BrownSpaceEngineering/PVDX-ADCS-PMB/PVDX-ADCS-PMB.step

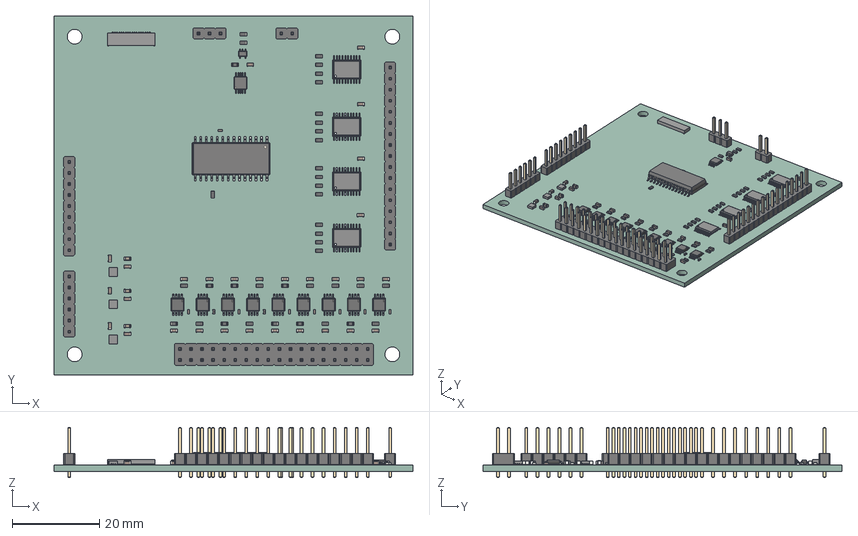
[picture p1: CAD file, 2026-08-29]
PVDX-ADCS-PMB.step
82.5 x 82.5 x 11.5 mm
C_0402_1005Metric x 10
R_0603_1608Metric x 38
BODY_MUA08A x 9
LEAD_MUA08A x 72
SOIC-28W_7.5x17.9mm_P1.27mm
C_0603_1608Metric x 29
BODY-SON x 3
PIN1-ID x 3
PinHeader_1x03_P2.54mm_Vertical
Pins
SOT-353_SC-70-5
SOP65P640X120-20N x 4
GRM188R61A226ME15D x 3
PinHeader_2x18_P2.54mm_Vertical
PinHeader_1x02_P2.54mm_Vertical
TSSOP-10_3x3mm_P0.5mm
PinHeader_1x09_P2.54mm_Vertical
PinHeader_1x17_P2.54mm_Vertical
PinHeader_1x06_P2.54mm_Vertical
PVDX-ADCS-PMB_PCB
