BrownSpaceEngineering/PVDX-ADCS-PMB/manufacturing/rev-1.1_2026-09-04/plots/PVDX-ADCS-PMB.pdf

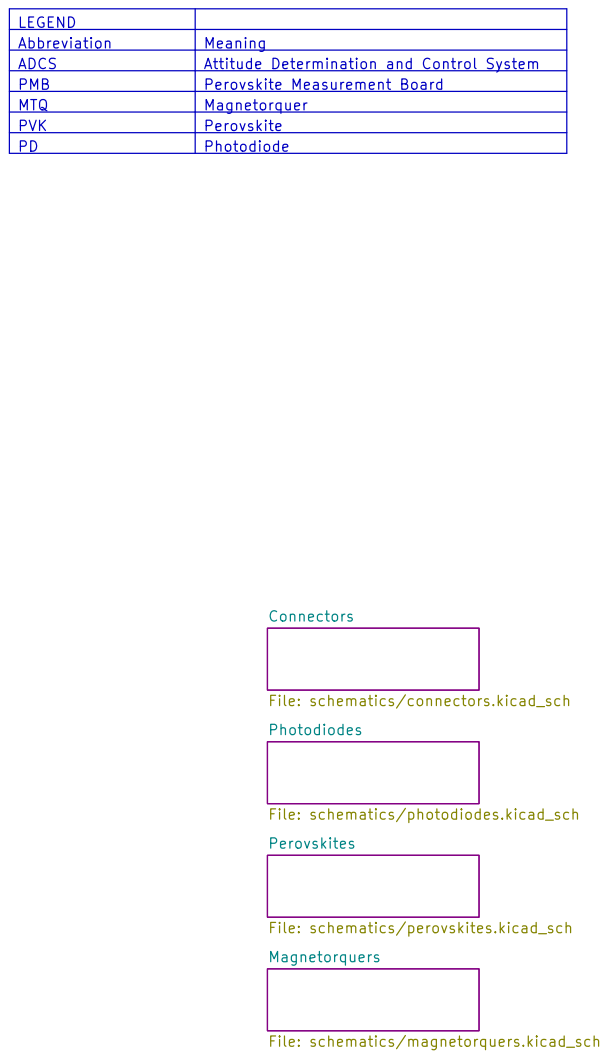
[picture p2: page 1]

LEGEND
Abbreviation | Meaning
ADCS | Attitude Determination and Control System

Magnetorquers File: schematics/magnetorquers.kicad_sch Connectors File: schematics/connectors.kicad_sch Photodiodes File: schematics/photodiodes.kicad_sch Perovskites File: schematics/perovskites.kicad_sch

Brown Space Engineering
Sheet: /
File: PVDX-ADCS-PMB.kicad_sch
Title: PVDX ADCS/PMB

Size: A4 | Rev: 1.1
KiCad E.D.A. 10.0.5 | Id: 1/5

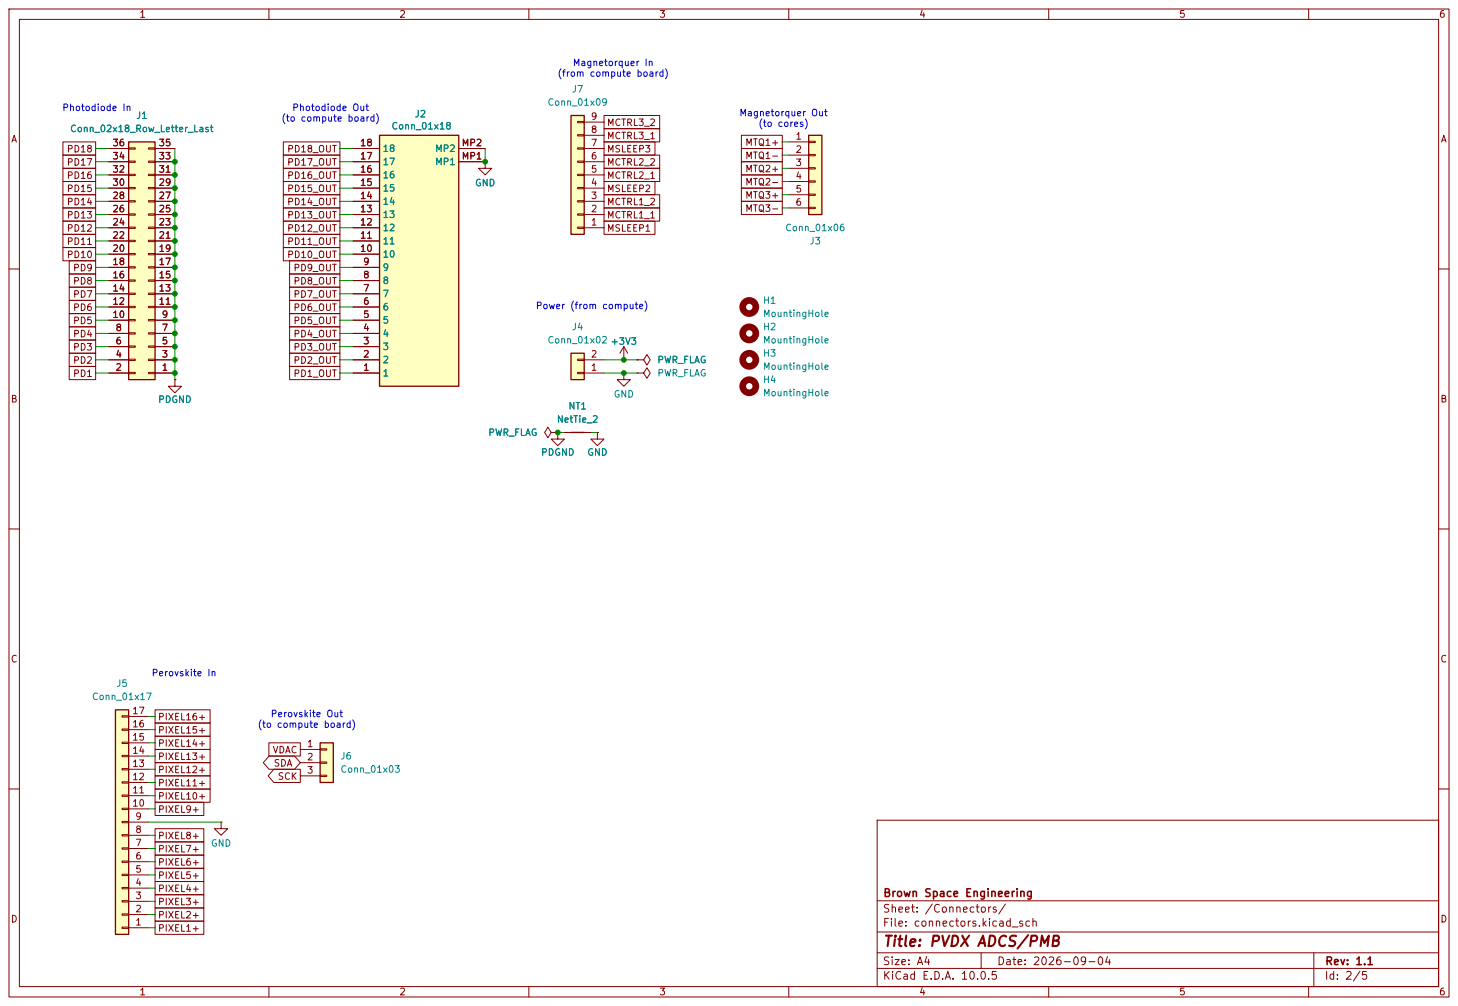
[picture p3: page 2]

Brown Space Engineering
Sheet: /Connectors/
File: connectors.kicad_sch
Title: PVDX ADCS/PMB

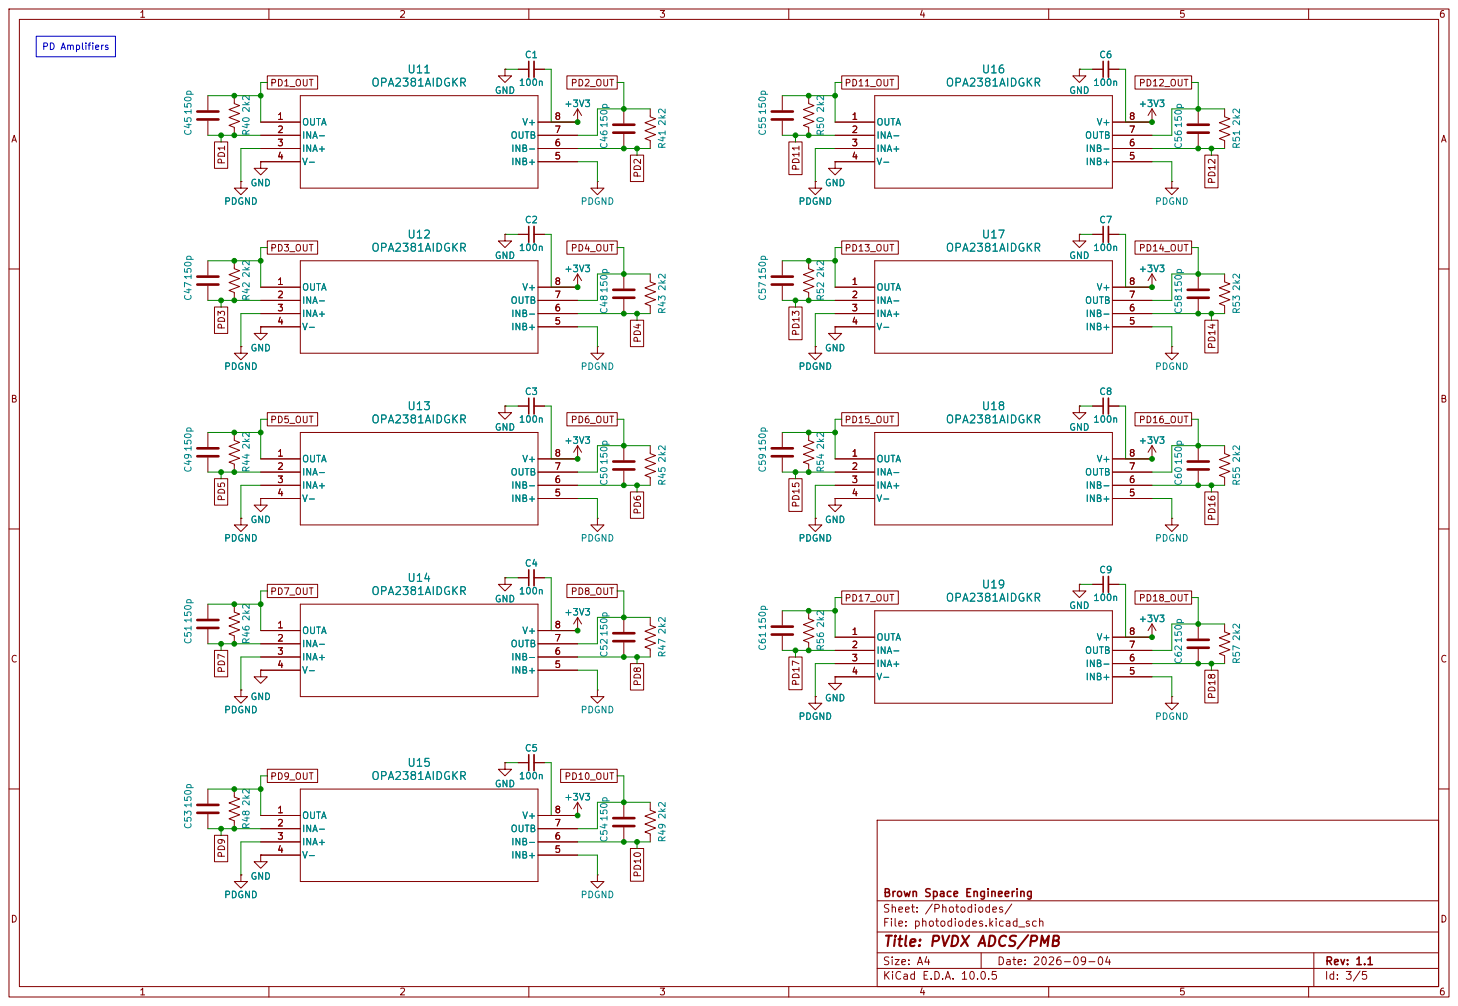
[picture p4: page 3]

Brown Space Engineering
Sheet: /Photodiodes/
File: photodiodes.kicad_sch
Title: PVDX ADCS/PMB

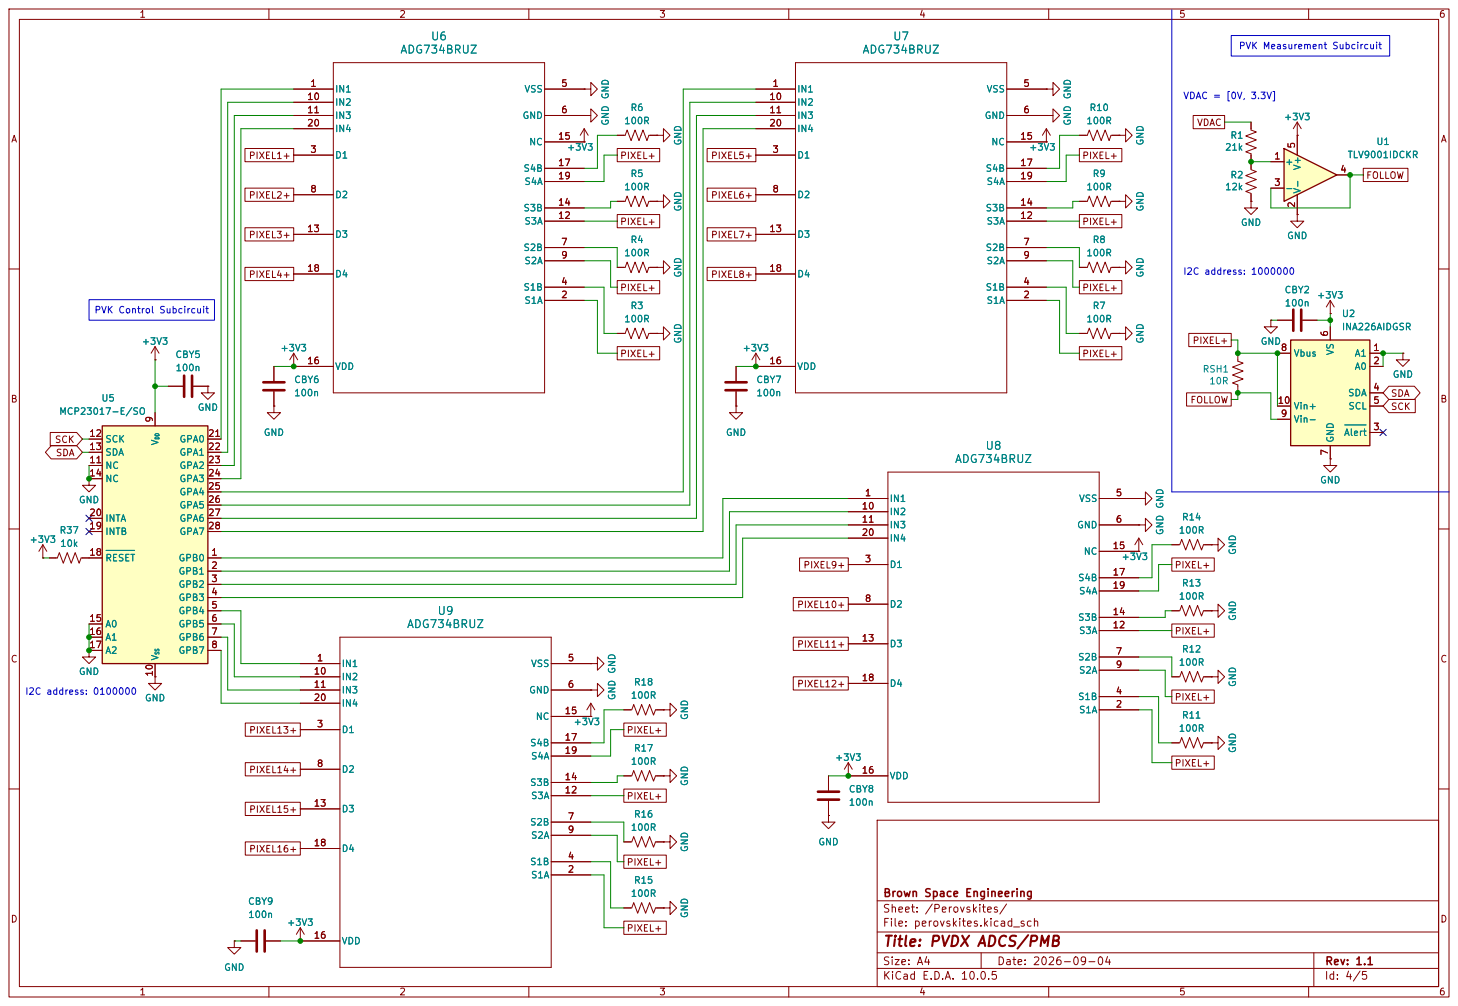
[picture p5: page 4]

Brown Space Engineering
Sheet: /Perovskites/
File: perovskites.kicad_sch
Title: PVDX ADCS/PMB

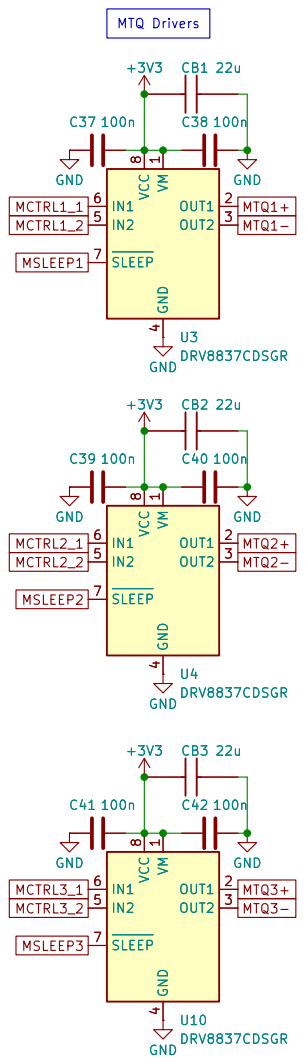
[picture p6: page 5]

Sheet: /Magnetorquers/
File: magnetorquers.kicad_sch
Title: PVDX ADCS/PMB
