BrownSpaceEngineering/PVDX-ADCS-PMB/spice/sims/PD_amplifier.asc

C1: cap; 150p
R1: res; 2.2k
U2: OPA2381
V1: voltage; 3.3V
Named nets: 0, PD_In, PD_Out
.lib ../models/OPA2381_LT.lib
Iph1  PD_In  0  PULSE(0 520u 10u 1n 1n 50u 100u)
D1    0  PD_In  DSFH2430
Rsh   PD_In  0  10G
Cj    PD_In  0  1000p
.model DSFH2430 D(IS=1p N=1.5 RS=15)
.tran 0 200u 0 10n
