BrownSpaceEngineering/PVDX-ADCS-PMB/spice/sims/perovskite_sim.asc

C1: cap; 10nF
D1: diode; DPV
I1: current; {Isc}
M1: nmos; MYNMOS
R1: res; 10k
R2: res; 10k
U1: UniversalOpAmp2
Vcc: voltage; 3.3V
Vdac: voltage; PWL(0 0 2m 0 22m 1.1)
Named nets: 0, VCC, Cell+
.model DPV D(Is=1e-14 N=1.5)
.param Isc=20m Rshunt=10k
.tran 22m
.model MYNMOS NMOS(Vto=1.0 Kp=5 Lambda=0.01)
