BrownSpaceEngineering/PVDX-ADCS-PMB/(commit log)

2026-08-24 100% mtq, 85% pd, 90% pmb
    [PVDX-ADCS-Board.kicad_pcb, connectors.kicad_sch, magnetorquers.kicad_sch, perovskites.kicad_sch, photodiodes.kicad_sch]
2026-08-26 100% layout, 90% silkscreen
    [PVDX-ADCS-Board.kicad_pcb, PVDX-ADCS-Board.step]
2026-08-27 Board complete: 100% silkscreen, repo renamed, NC pins tied; awaiting design review
    [PVDX-ADCS-Board.kicad_sch, PVDX-ADCS-Board.step, PVDX-ADCS-PMB.kicad_pcb, PVDX-ADCS-PMB.kicad_sch, PVDX-ADCS-PMB.step, connectors.kicad_sch, magnetorquers.kicad_sch, perovskites.kicad_sch]
2026-08-28 silkscreen edits
    [PVDX-ADCS-PMB.kicad_pcb]
2026-08-29 connect PDGNDs to GND
    [PVDX-ADCS-PMB.kicad_pcb, connectors.kicad_sch, photodiodes.kicad_sch]
2026-08-29 fix silkscreen, regen STEP, fix for ERC/DRC
    [.step, PVDX-ADCS-PMB.kicad_pcb, connectors.kicad_sch]
2026-08-29 rename STEP
    [.step, PVDX-ADCS-PMB.step]
2026-09-04 Prepared for fab: generated gerbers, switched PD C_fb from 22pF to 150pF, generated BOM, updated readme
    [PVDX-ADCS-PMB-B_Cu.gbl, PVDX-ADCS-PMB-B_Mask.gbs, PVDX-ADCS-PMB-B_Paste.gbp, PVDX-ADCS-PMB-B_Silkscreen.gbo, PVDX-ADCS-PMB-Edge_Cuts.gm1, PVDX-ADCS-PMB-F_Cu.gtl, PVDX-ADCS-PMB-F_Mask.gts, PVDX-ADCS-PMB-F_Paste.gtp]
2026-09-05 fix BOM, generate .pos, fix component values, re-plot schematics
    [PVDX-ADCS-PMB-B_Cu.gbl, PVDX-ADCS-PMB-B_Mask.gbs, PVDX-ADCS-PMB-B_Silkscreen.gbo, PVDX-ADCS-PMB-Edge_Cuts.gm1, PVDX-ADCS-PMB-F_Cu.gtl, PVDX-ADCS-PMB-F_Mask.gts, PVDX-ADCS-PMB-F_Paste.gtp, PVDX-ADCS-PMB-F_Silkscreen.gto]
